slemanz/nina-project/HW/Schematic/HW.pdf

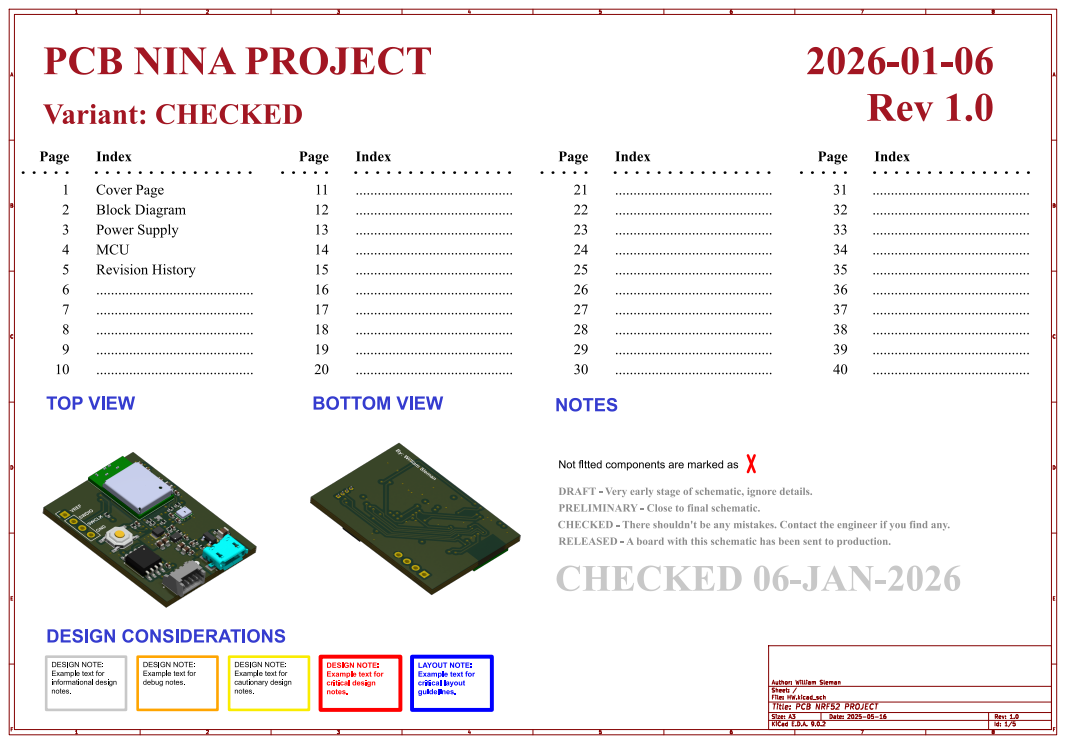
[picture p3: page 1]

Not fitted components are marked as

DRAFT - Veryearlystageof schematic,ignoredetails.
PRELIMINARY - Closetofinal schematic.
CHECKED - Thereshouldn'tbeanymistakes.Contacttheengineerif youfindany.
CHECKED 06-JAN-2026

File: sheet2.kicad_sch DESIGN NOTE: Example text for

guidelines. DESIGN NOTE: Example text for cautionary design

File: HW.kicad_sch Sheet: / Author: William Sleman

Id: 1/5 Title: PCB NRF52 PROJECT

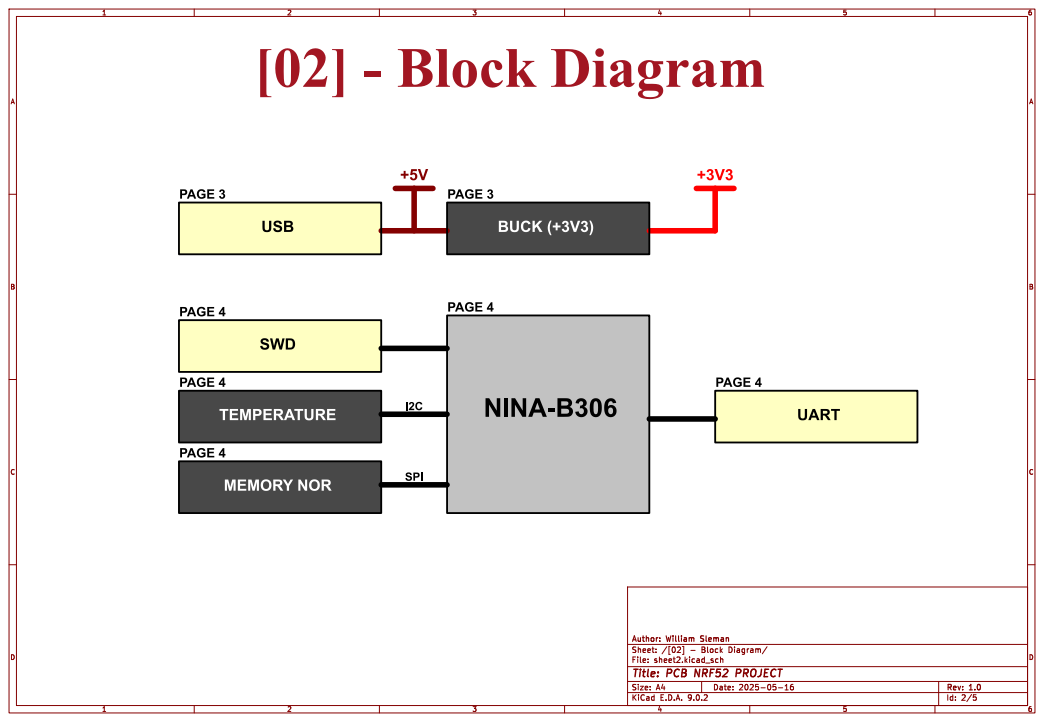
[picture p4: page 2]

NINA-B306

MEMORY NOR

Id: 2/5 Title: PCB NRF52 PROJECT

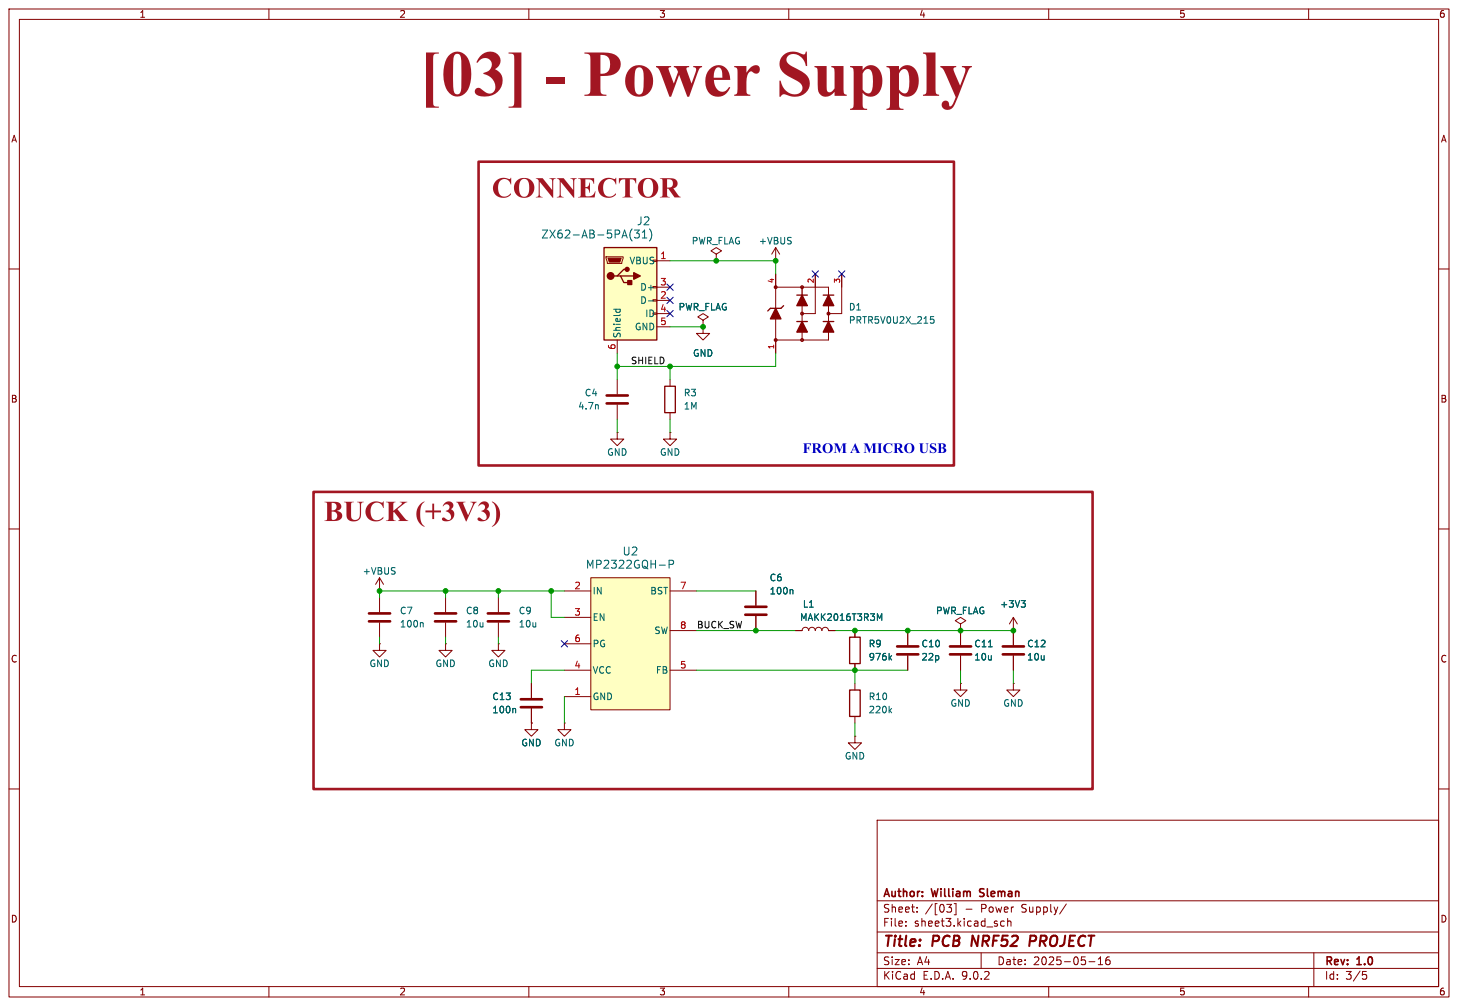
[picture p5: page 3]

Id: 3/5 Title: PCB NRF52 PROJECT

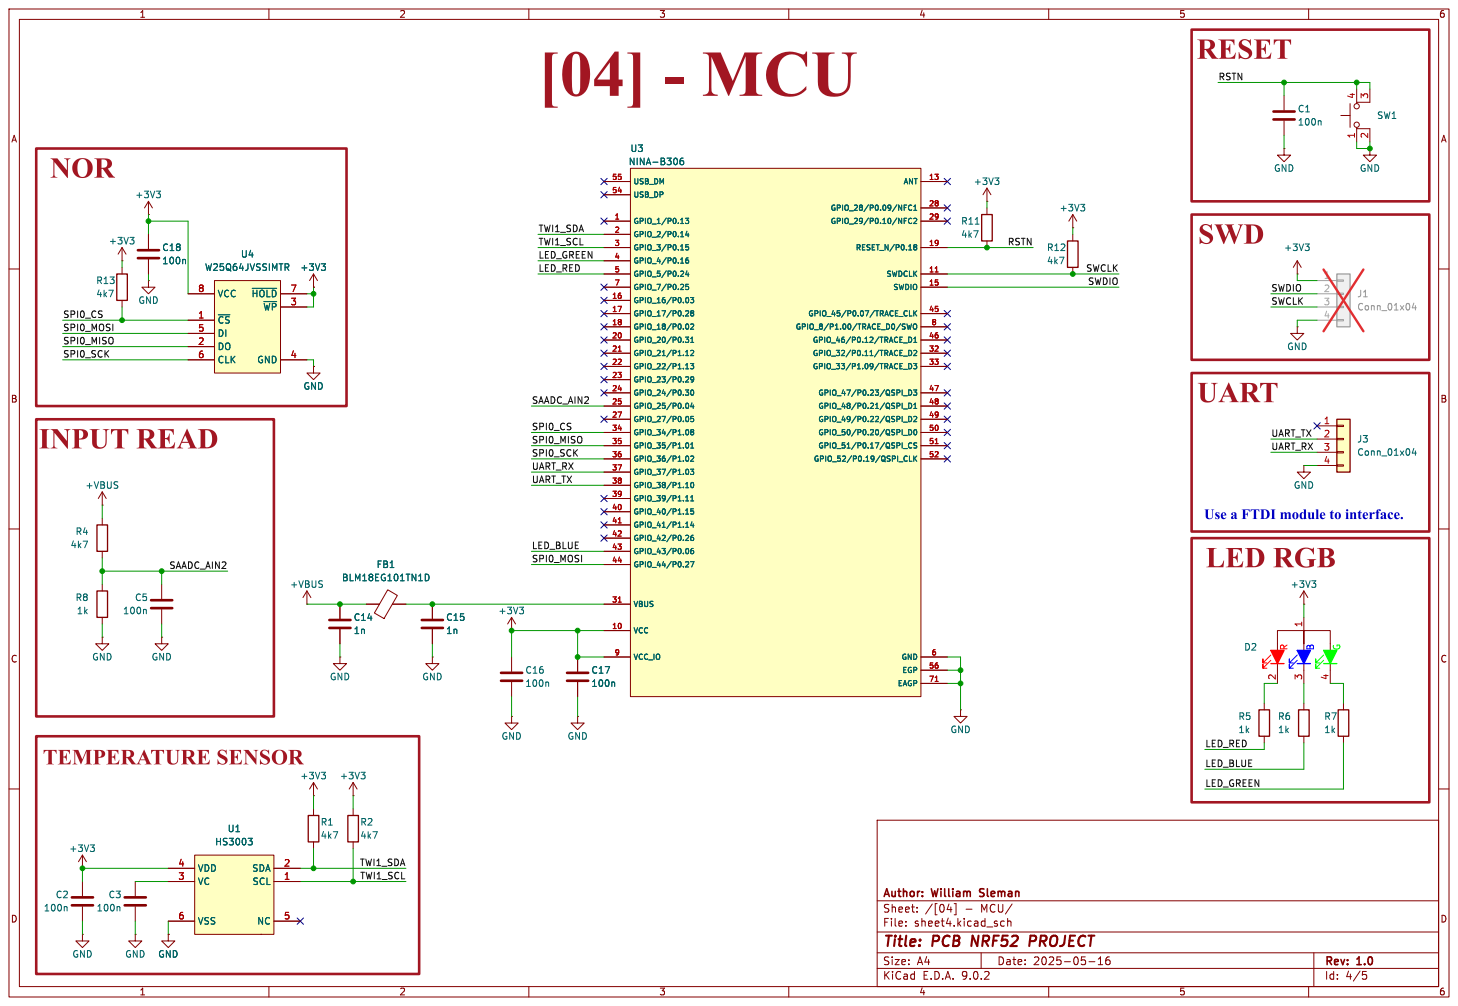
[picture p6: page 4]

Id: 4/5 Title: PCB NRF52 PROJECT

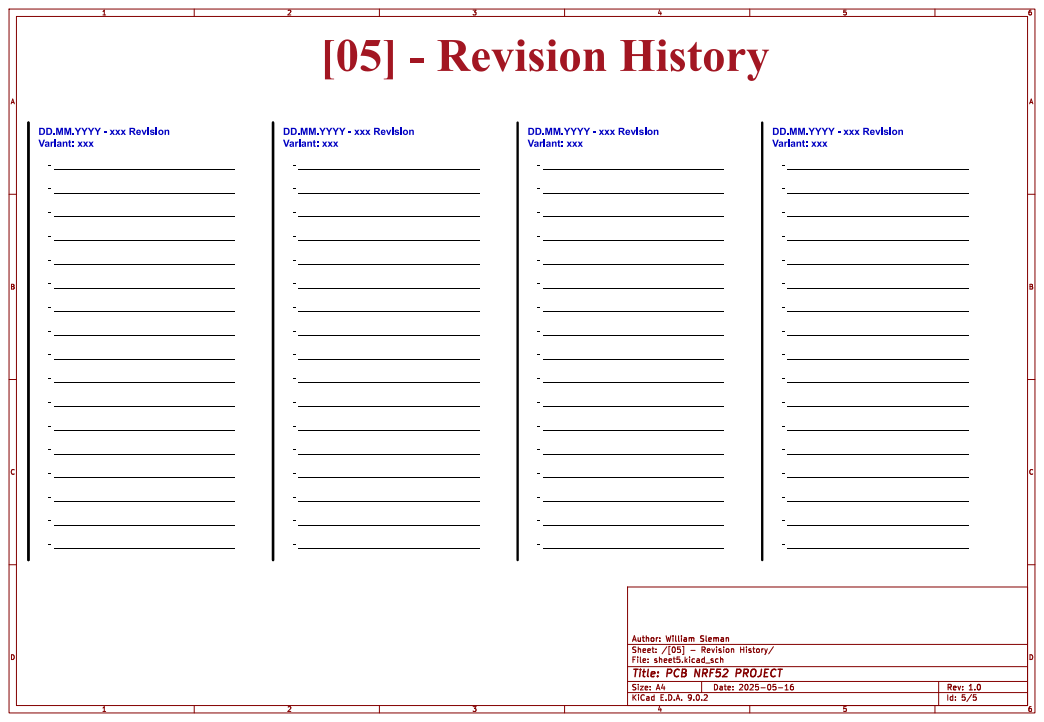
[picture p7: page 5]

- _________________________________ DD.MM.YYYY - xxx Revision
Variant: xxx

Variant: xxx DD.MM.YYYY - xxx Revision

DD.MM.YYYY - xxx Revision

Id: 5/5 Title: PCB NRF52 PROJECT
