slemanz/nina-project/HW/HW.kicad_pcb

## KiCad design HW/HW.kicad_pcb (2025-06-03)

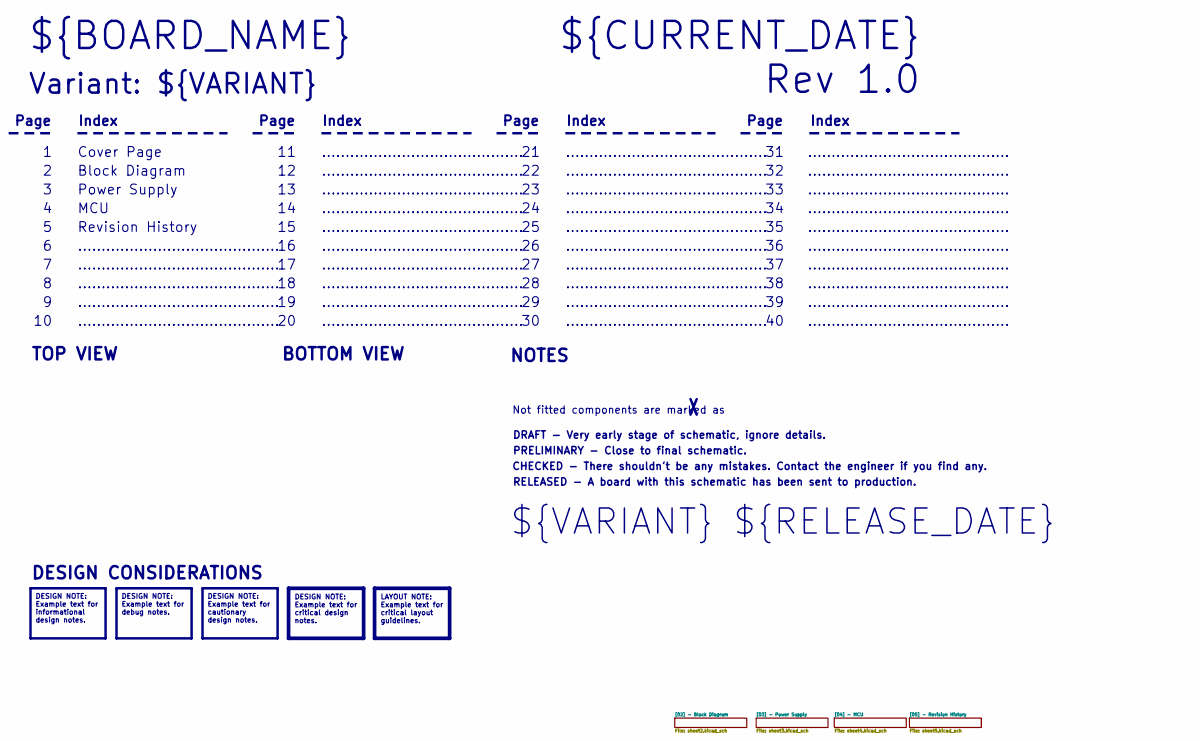
[picture p8: schematic HW.kicad_sch, PCB NRF52 PROJECT]

Notes on the sheet:
...........................................
DRAFT - Very early stage of schematic, ignore details.
Index
Page
Cover Page
MCU
Revision History
TOP VIEW
CHECKED - There shouldn't be any mistakes. Contact the engineer if you find any.
DESIGN CONSIDERATIONS
Block Diagram
BOTTOM VIEW
${CURRENT_DATE}
NOTES
Not fitted components are marked as
PRELIMINARY - Close to final schematic.
Variant: ${VARIANT}
Power Supply
RELEASED - A board with this schematic has been sent to production.
${BOARD_NAME}
Rev ${REVISION}
${VARIANT} ${RELEASE_DATE}
DESIGN NOTE: Example text for informational design notes.
DESIGN NOTE: Example text for critical design notes.
LAYOUT NOTE: Example text for critical layout guidelines.
DESIGN NOTE: Example text for cautionary design notes.
DESIGN NOTE: Example text for debug notes.

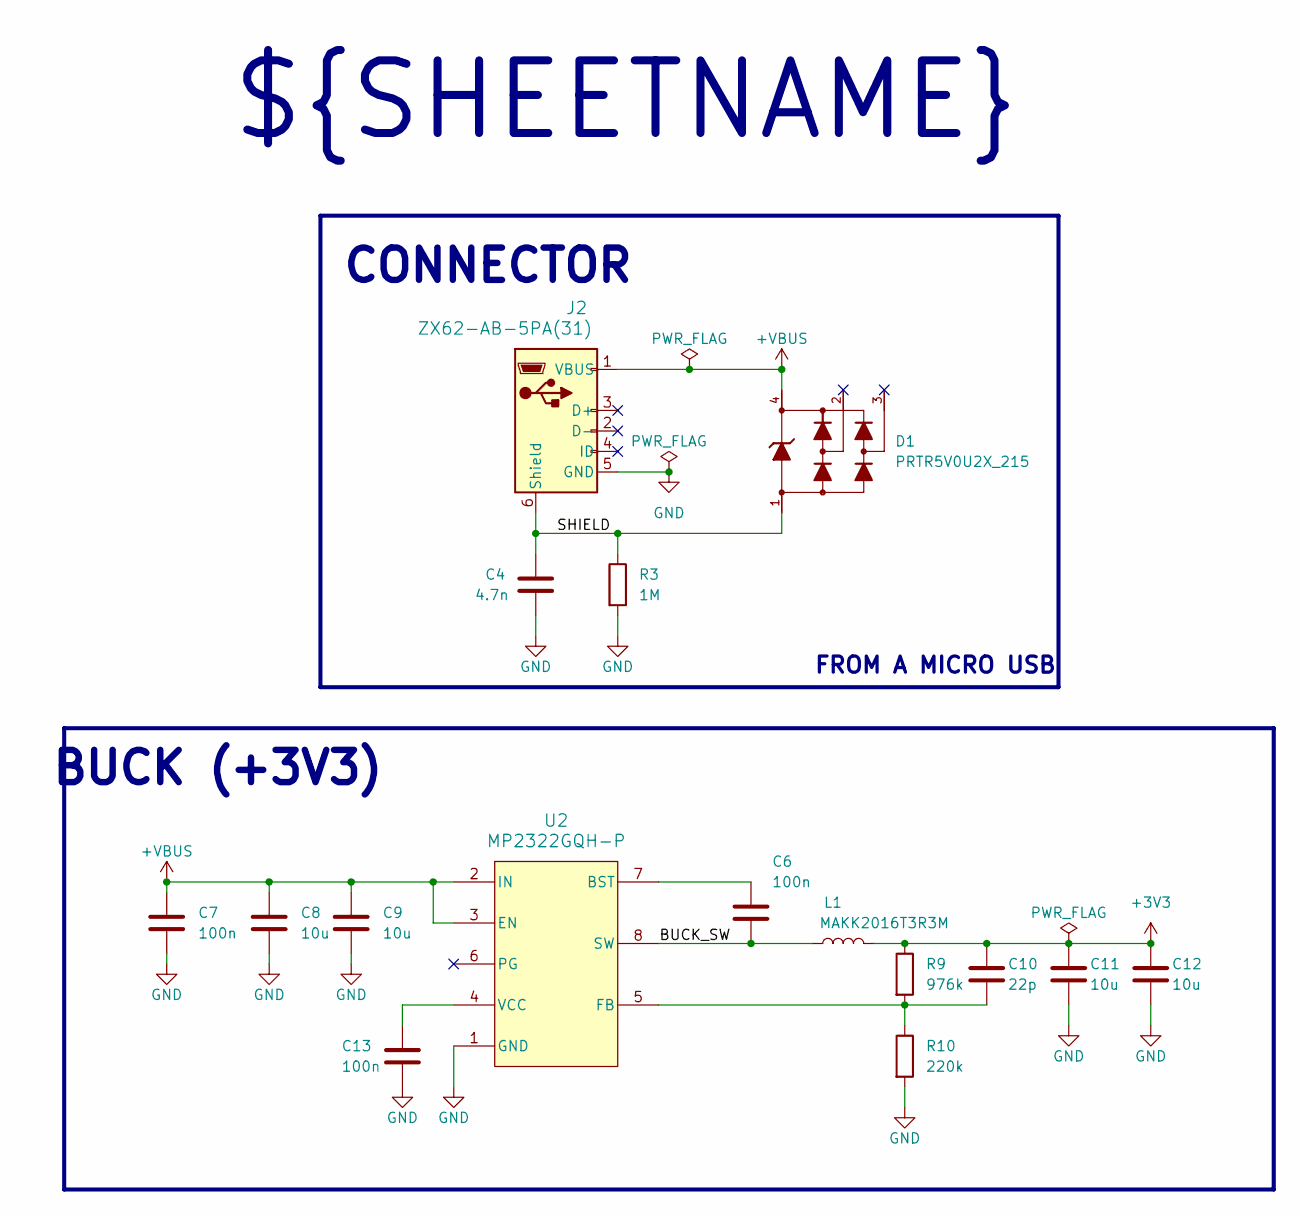
[picture p9: schematic sheet3.kicad_sch, PCB NRF52 PROJECT]

Parts:
C4: 4.7n; C_0805_2012Metric
C6, C7, C13: 100n; C_0402_1005Metric
C8, C9, C11, C12: 10u; C_0603_1608Metric
C10: 22p; C_0402_1005Metric
D1: PRTR5V0U2X_215; SOT143B
J2: ZX62-AB-5PA(31); CONN5_ZX62-AB-5PA_HIR
L1: MAKK2016T3R3M; INDC2016X100N
R3: 1M; R_0402_1005Metric
R9: 976k; R_0402_1005Metric
R10: 220k; R_0402_1005Metric
U2: MP2322GQH-P; QFN-8_1p5MMx2MM_MNP

Connections:
+3V3: C10.1, C11.1, C12.1, L1.2, R9.1; also elsewhere on the board
+VBUS: C7.1, C8.1, C9.1, D1.4, J2.1 (VBUS), U2.2 (IN), U2.3 (EN); also elsewhere on the board
/[03] - Power Supply/BUCK_SW: C6.2, L1.1, U2.8 (SW)
/[03] - Power Supply/SHIELD: C4.1, D1.1, J2.6 (Shield), J2.7 (Shield), J2.8 (Shield), J2.9 (Shield), R3.1
GND: C4.2, C7.2, C8.2, C9.2, C11.2, C12.2, C13.2, J2.5 (GND), R3.2, R10.2, U2.1 (GND); also elsewhere on the board
unnamed: C6.1, U2.7 (BST)
unnamed: C10.2, R9.2, R10.1, U2.5 (FB)
unnamed: C13.1, U2.4 (VCC)

Notes on the sheet:
BUCK (+3V3)
CONNECTOR
FROM A MICRO USB
${SHEETNAME}

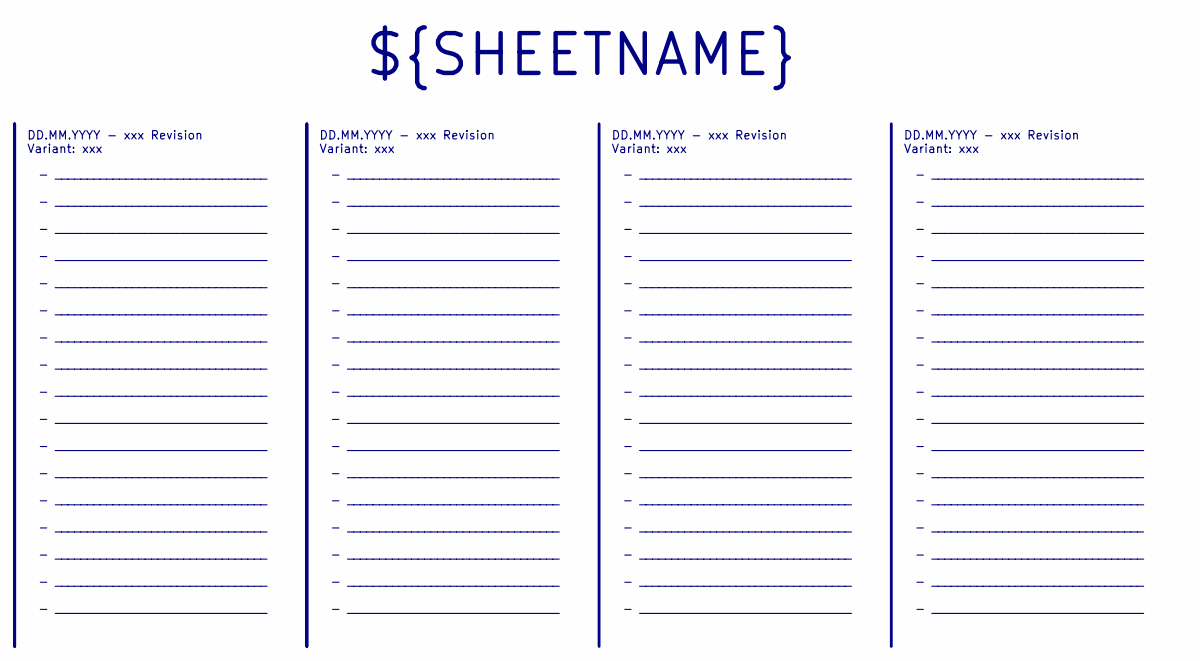
[picture p10: schematic sheet5.kicad_sch, PCB NRF52 PROJECT]

Notes on the sheet:
${SHEETNAME}
DD.MM.YYYY - xxx Revision Variant: xxx
- _________________________________ - _________________________________ - _________________________________ - _________________________________ - _________________________________ - _________________________________ - _________________________________ - _________________________________ - _________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

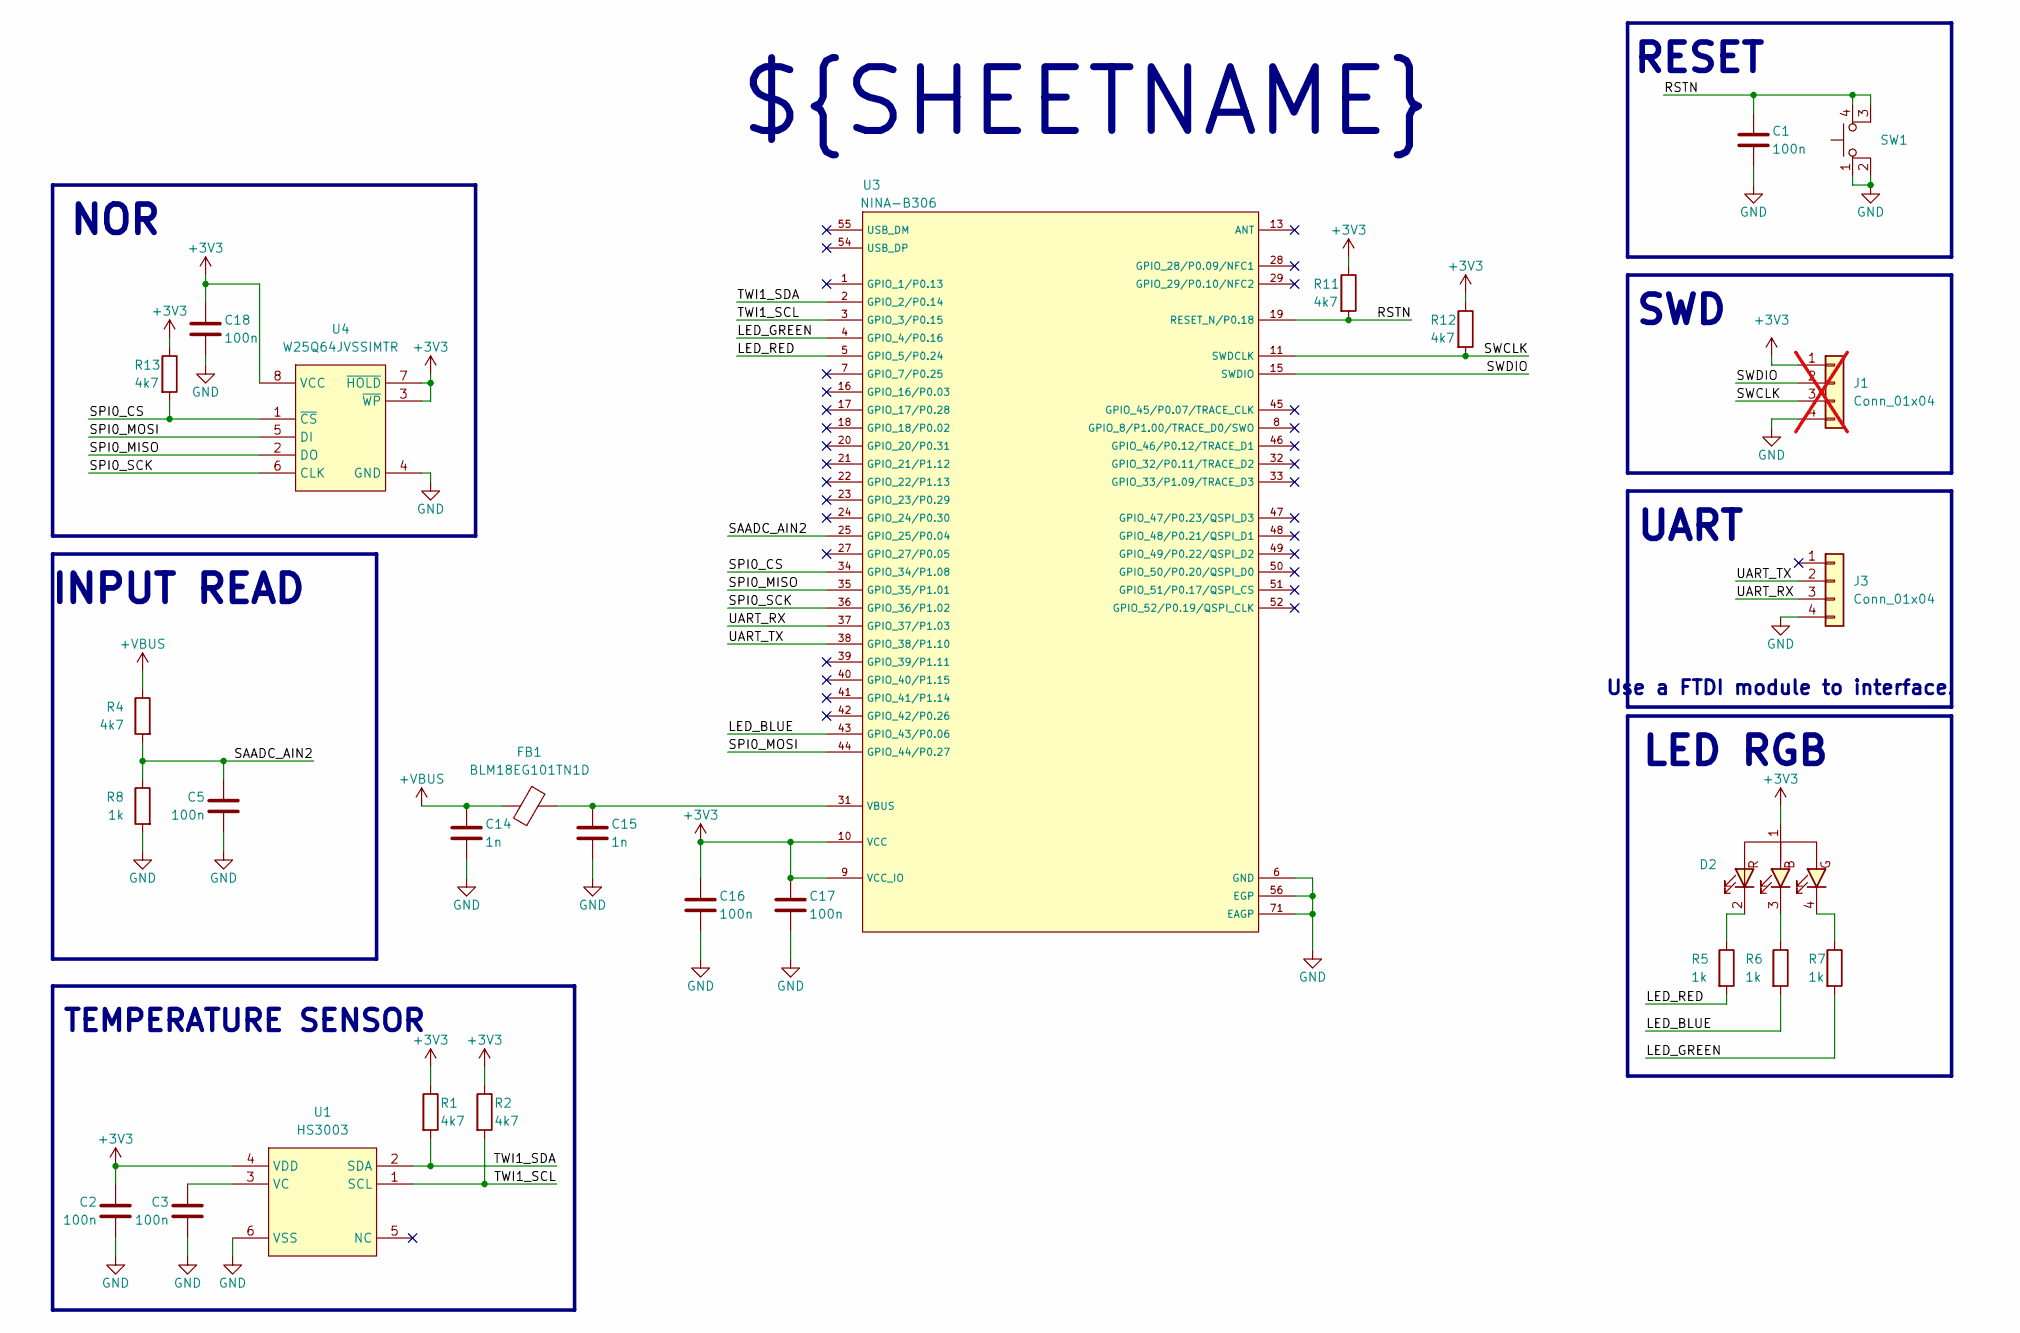
[picture p11: schematic sheet4.kicad_sch, PCB NRF52 PROJECT]

Parts:
C1, C2, C3, C5, C16, C17, C18: 100n; C_0402_1005Metric
C14, C15: 1n; C_0402_1005Metric
D2: LED_SML-P24M_ROM
FB1: BLM18EG101TN1D; L_0603_1608Metric
J1: Conn_01x04; PinHeader_1x04_P2.54mm_Vertical; not fitted
J3: Conn_01x04; MOLEX_530480410
R1, R2, R4, R11, R12, R13: 4k7; R_0402_1005Metric
R5, R6, R7, R8: 1k; R_0402_1005Metric
SW1: PTS526SK15SMTR2LFS; SW-SMD_4P-L5.2-W5.2-P3.70-LS6.4; LCSC C2689521
U1: HS3003; XDCR_HS3003
U3: NINA-B306; NINA_LGA71R_1500X1000X223_PCB
U4: W25Q64JVSSIMTR; SOIC-8_5.3x5.3mm_P1.27mm

Connections:
+3V3: C2.1, C16.1, C17.1, C18.1, D2.1, J1.1, R1.1, R2.1, R11.1, R12.1, R13.1, U1.4 (VDD), U3.9 (VCC_IO), U3.10 (VCC), U4.3 (~WP), U4.7 (~HOLD), U4.8 (VCC); also elsewhere on the board
+VBUS: C14.1, FB1.1, R4.1; also elsewhere on the board
/[04] - MCU/LED_BLUE: R6.2, U3.43 (GPIO_43/P0.06)
/[04] - MCU/LED_GREEN: R7.2, U3.4 (GPIO_4/P0.16)
/[04] - MCU/LED_RED: R5.2, U3.5 (GPIO_5/P0.24)
/[04] - MCU/RSTN: C1.1, R11.2, SW1.3, SW1.4, U3.19 (RESET_N/P0.18)
/[04] - MCU/SAADC_AIN2: C5.1, R4.2, R8.1, U3.25 (GPIO_25/P0.04)
/[04] - MCU/SPI0_CS: R13.2, U3.34 (GPIO_34/P1.08), U4.1 (~CS)
/[04] - MCU/SPI0_MISO: U3.35 (GPIO_35/P1.01), U4.2 (DO)
/[04] - MCU/SPI0_MOSI: U3.44 (GPIO_44/P0.27), U4.5 (DI)
/[04] - MCU/SPI0_SCK: U3.36 (GPIO_36/P1.02), U4.6 (CLK)
/[04] - MCU/SWCLK: J1.3, R12.2, U3.11 (SWDCLK)
/[04] - MCU/SWDIO: J1.2, U3.15 (SWDIO)
/[04] - MCU/TWI1_SCL: R2.2, U1.1 (SCL), U3.3 (GPIO_3/P0.15)
/[04] - MCU/TWI1_SDA: R1.2, U1.2 (SDA), U3.2 (GPIO_2/P0.14)
/[04] - MCU/UART_RX: J3.3, U3.37 (GPIO_37/P1.03)
/[04] - MCU/UART_TX: J3.2, U3.38 (GPIO_38/P1.10)
GND: C1.2, C2.2, C3.2, C5.2, C14.2, C15.2, C16.2, C17.2, C18.2, J1.4, J3.4, R8.2, SW1.1, SW1.2, U1.6 (VSS), U3.6 (GND), U3.12 (GND), U3.14 (GND), U3.26 (GND), U3.30 (GND), U3.53 (GND), U3.56 (EGP), U3.57 (EGP), U3.58 (EGP), U3.59 (EGP), U3.60 (EGP), U3.61 (EGP), U3.62 (EGP), U3.63 (EGP), U3.64 (EGP), U3.65 (EGP), U3.66 (EGP), U3.67 (EGP), U3.68 (EAGP), U3.69 (EAGP), U3.70 (EAGP), U3.71 (EAGP), U4.4 (GND); also elsewhere on the board
unnamed: D2.2, R5.1
unnamed: D2.3, R6.1
unnamed: D2.4, R7.1
unnamed: C3.1, U1.3 (VC)
unnamed: C15.1, FB1.2, U3.31 (VBUS)

Notes on the sheet:
TEMPERATURE SENSOR
NOR
LED RGB
SWD
UART
${SHEETNAME}
Use a FTDI module to interface.
RESET
INPUT READ

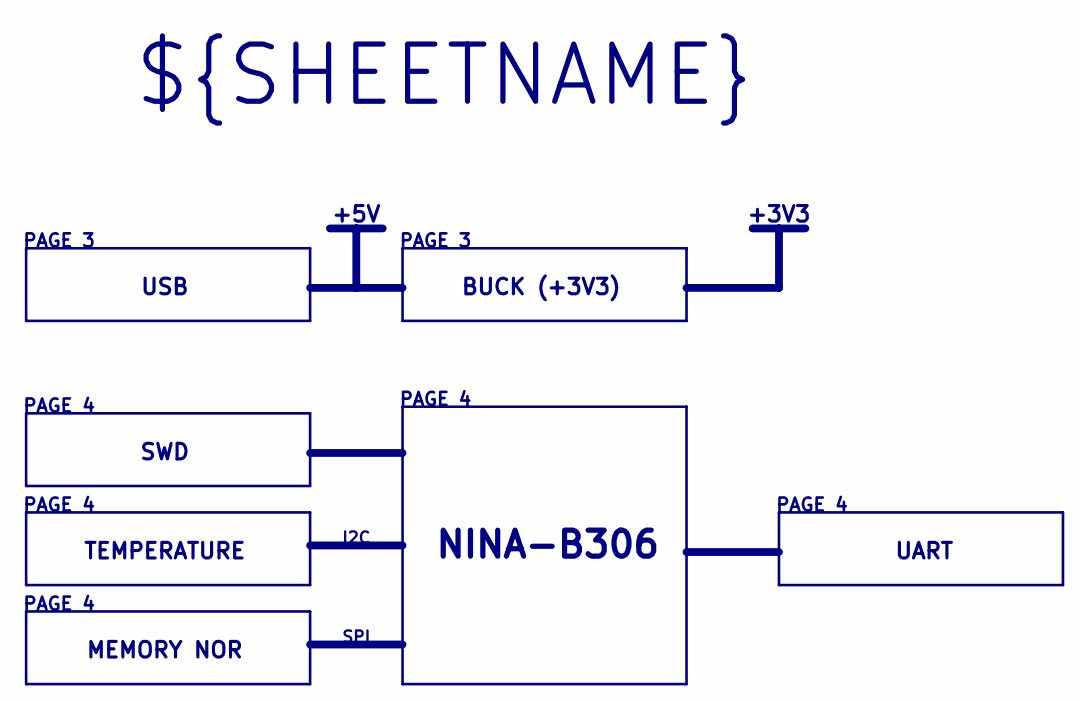
[picture p12: schematic sheet2.kicad_sch, PCB NRF52 PROJECT]

Notes on the sheet:
UART
+5V
BUCK (+3V3)
PAGE 4
SWD
PAGE 3
MEMORY NOR
NINA-B306
I2C
USB
SPI
${SHEETNAME}
+3V3
TEMPERATURE

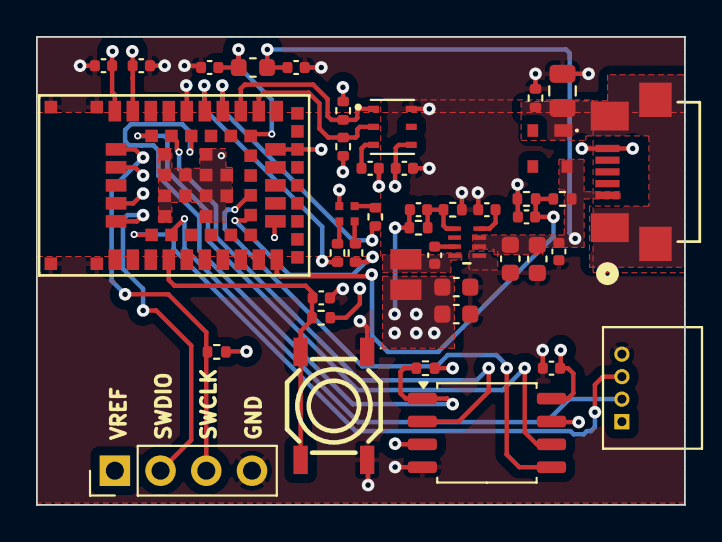
[picture p13: board HW.kicad_pcb from above]

Board: 4 copper layers, 36.0 x 26.0 mm, 43 parts (0 on the bottom side), 28 nets.
