slemanz/nina-project/(commit log)

2025-05-26 project(feat): add kicad HW project
2025-05-26 project(feat): add schematic project
    [HW.kicad_sch]
2025-05-27 project(feat): add footprint table
2025-05-28 project(feat): add sheet2
    [sheet2.kicad_sch]
2025-05-28 project(feat): add sheet3
    [sheet3.kicad_sch]
2025-06-01 project(feat): add sheet4
    [sheet4.kicad_sch]
2025-06-02 project(feat): add sheet5
    [sheet5.kicad_sch]
2025-06-03 project(feat): add pcb project
    [HW.kicad_pcb]
2025-06-07 project(feat): add schematic in pdf
2025-06-07 project(feat): add 3d images from board
2026-01-06 HW(feat): change schematic to checked
